c-devine/TachClock/(commit log)

2019-04-14 12 and 0 hour fixes.
    [TachClock.ino]
2019-04-14 Removed println.
